gndean/bmx-start-gate/images/002-DSC09042.JPG

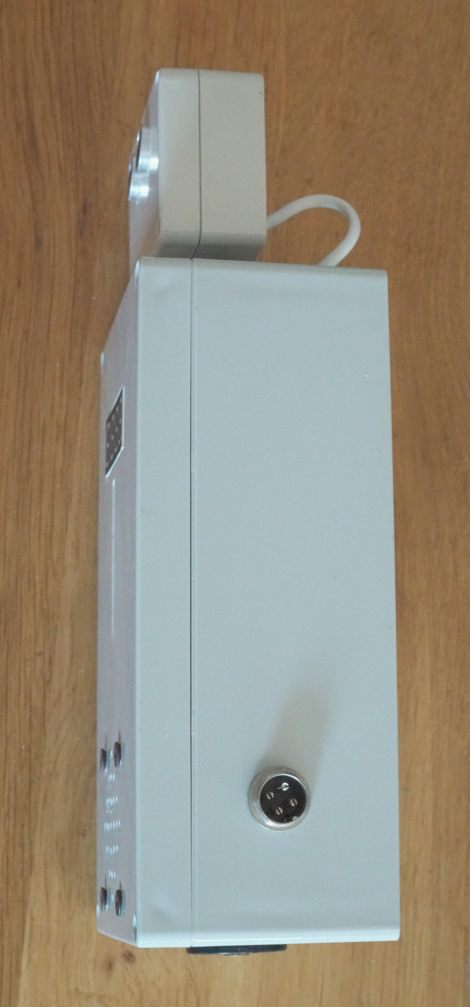
images/002-DSC09042.JPG
