gndean/bmx-start-gate/images/003-DSC09043.JPG

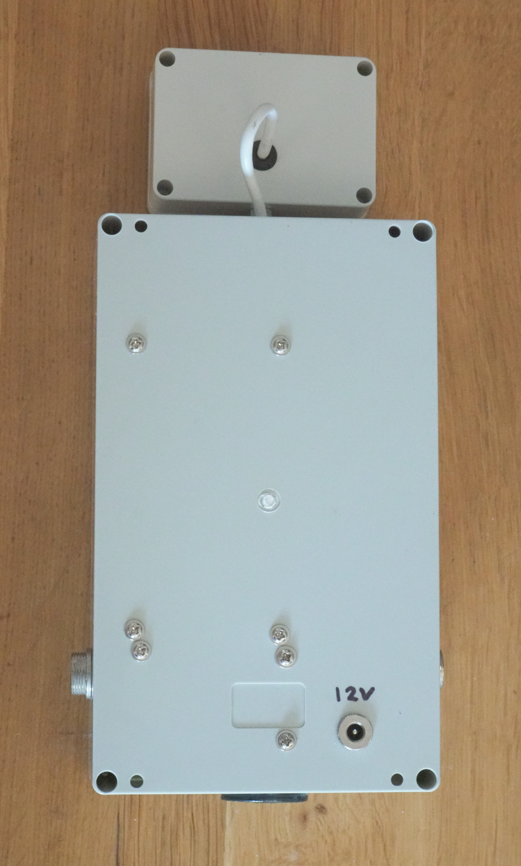
images/003-DSC09043.JPG
