gndean/bmx-start-gate/images/004-DSC09046.JPG

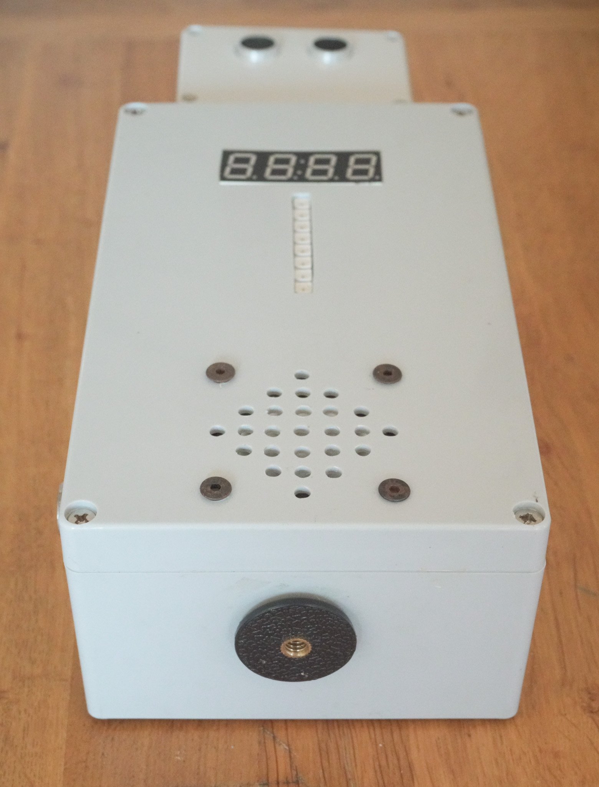
images/004-DSC09046.JPG
