gndean/bmx-start-gate/images/005-DSC09047.JPG

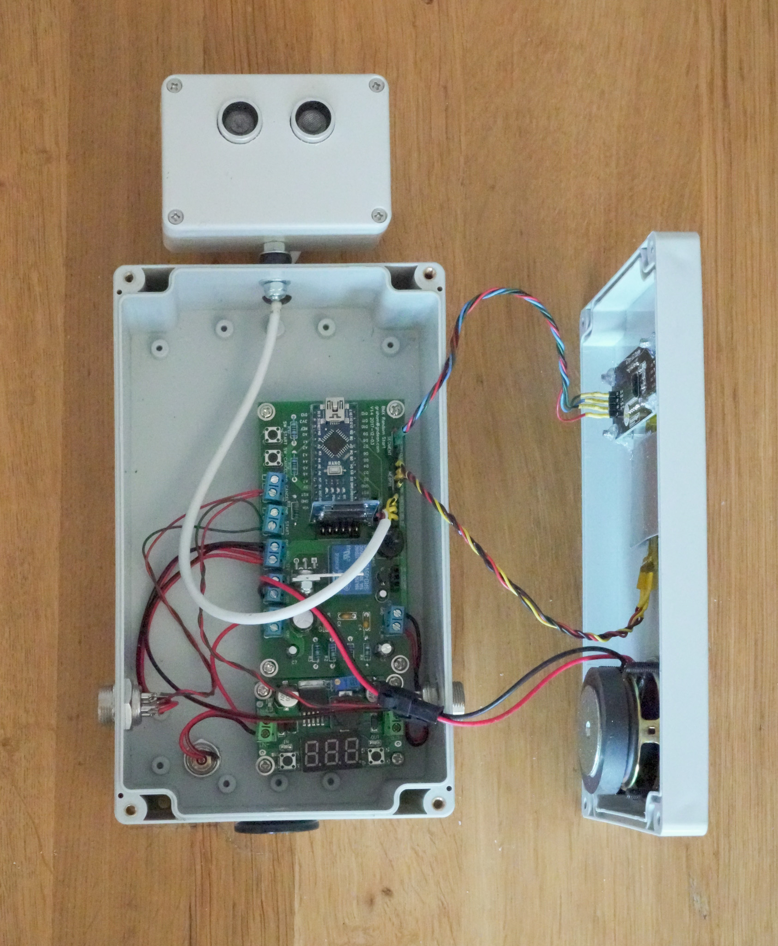
images/005-DSC09047.JPG
