gndean/bmx-start-gate/images/007-DSC09054.JPG

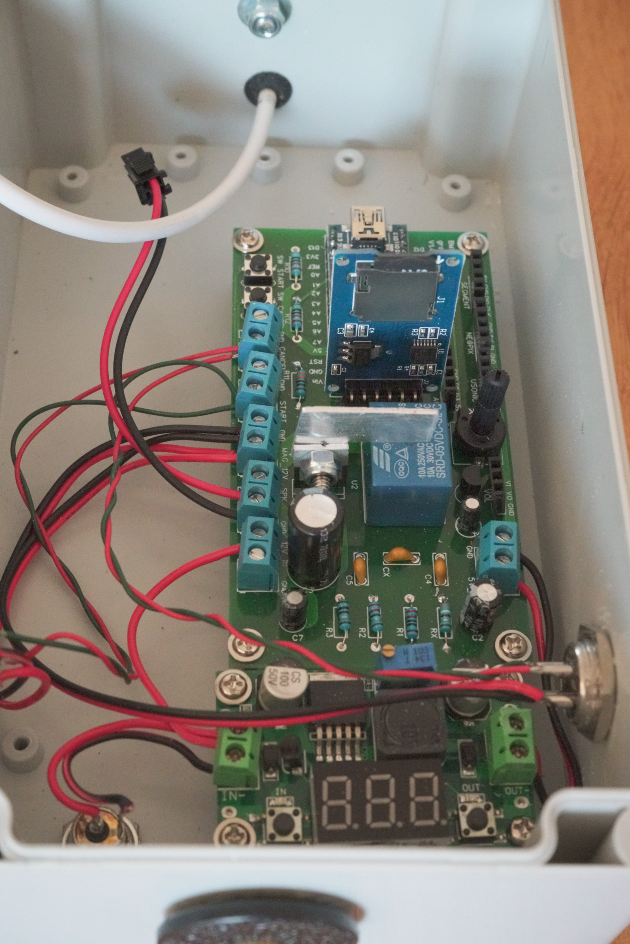
images/007-DSC09054.JPG
