gndean/bmx-start-gate/images/008-DSC09060.JPG

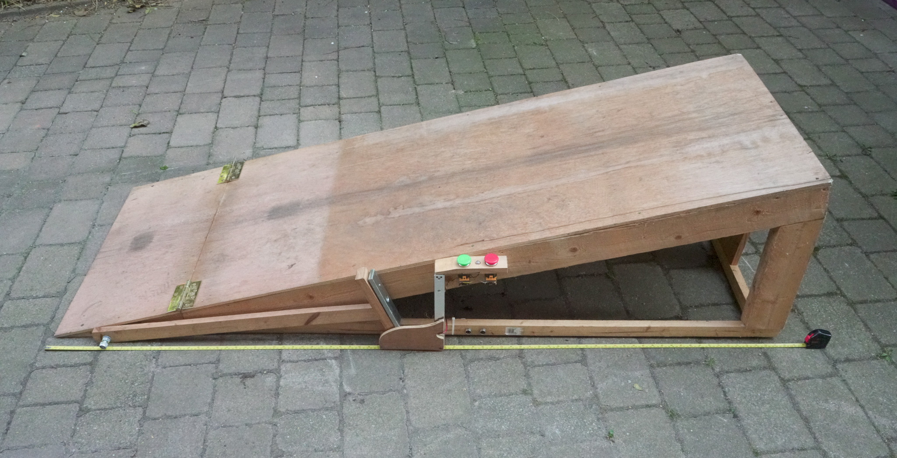
images/008-DSC09060.JPG
