gndean/bmx-start-gate/images/009-DSC09062.JPG

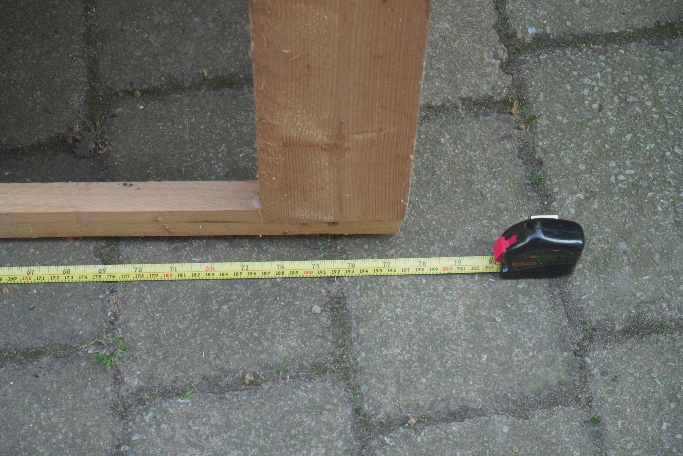
images/009-DSC09062.JPG
