gndean/bmx-start-gate/images/010-DSC09063.JPG

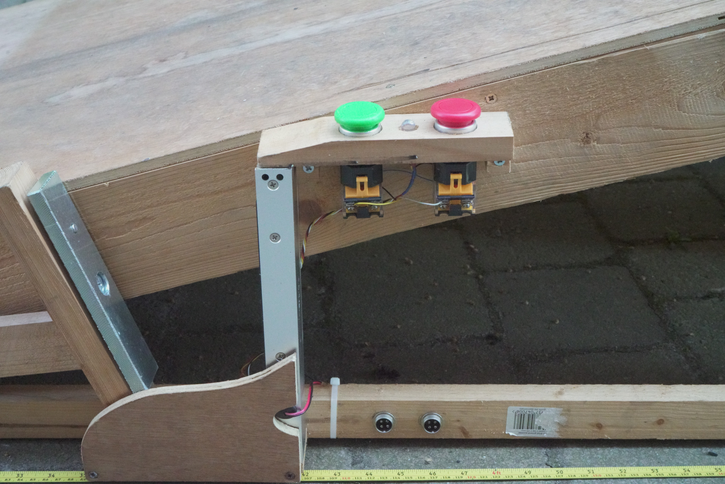
images/010-DSC09063.JPG
