gndean/bmx-start-gate/images/011-DSC09066.JPG

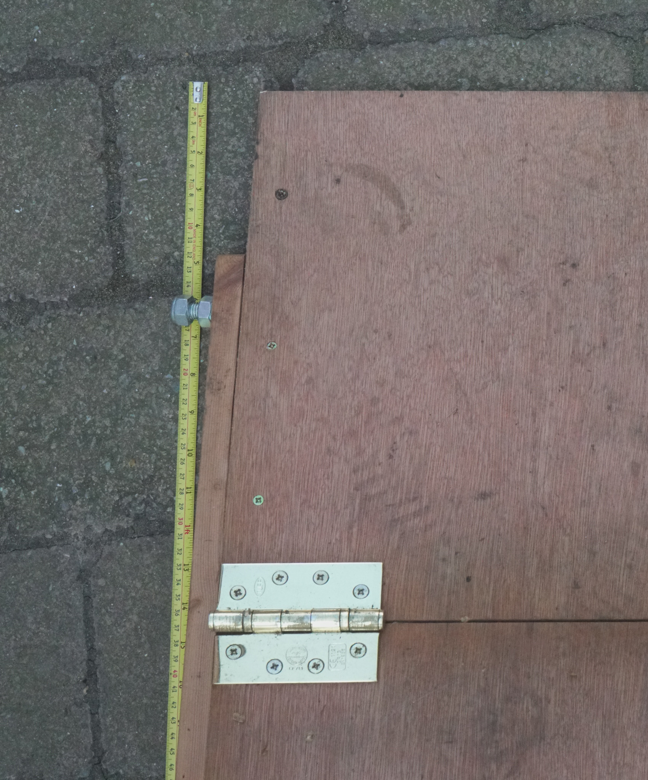
images/011-DSC09066.JPG
