gndean/bmx-start-gate/images/012-DSC09067.JPG

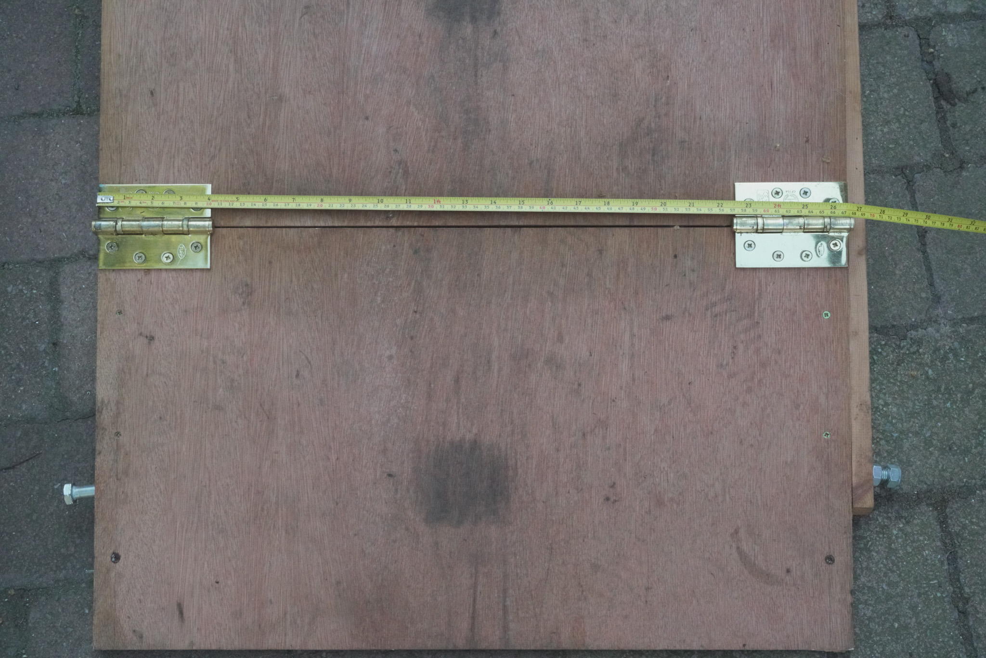
images/012-DSC09067.JPG
