gndean/bmx-start-gate/images/013-DSC09070.JPG

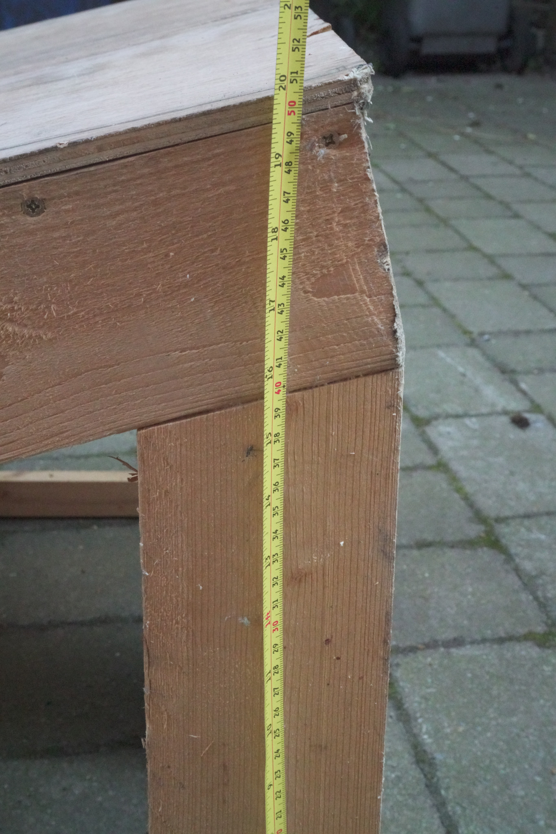
images/013-DSC09070.JPG
