gndean/bmx-start-gate/images/014-DSC09071.JPG

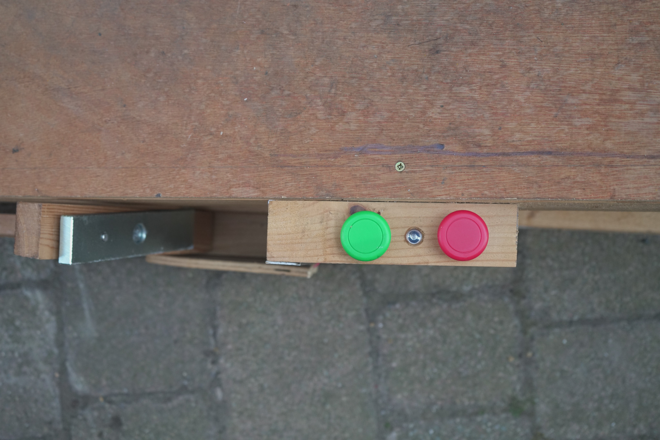
images/014-DSC09071.JPG
