gndean/bmx-start-gate/images/015-DSC09072.JPG

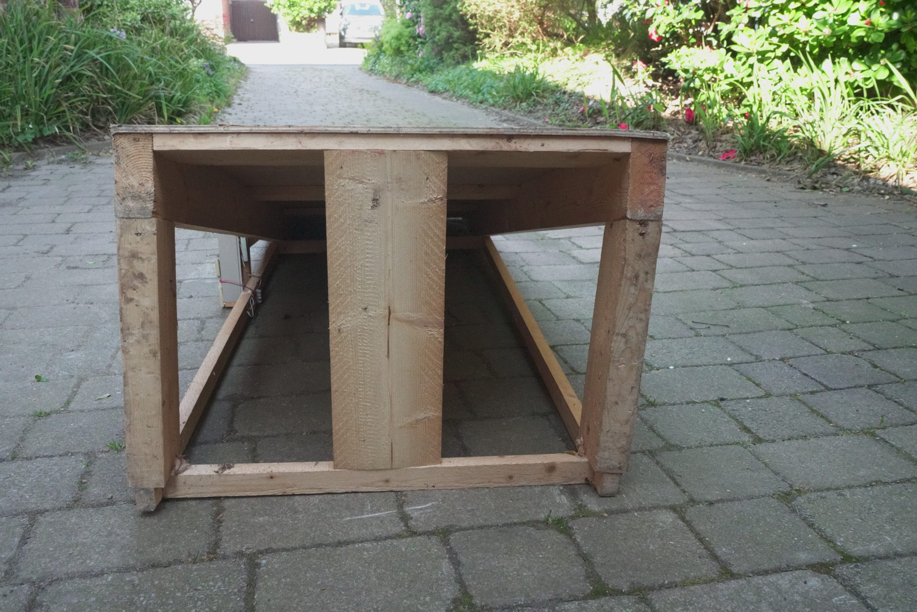
images/015-DSC09072.JPG
