gndean/bmx-start-gate/images/016-DSC09074.JPG

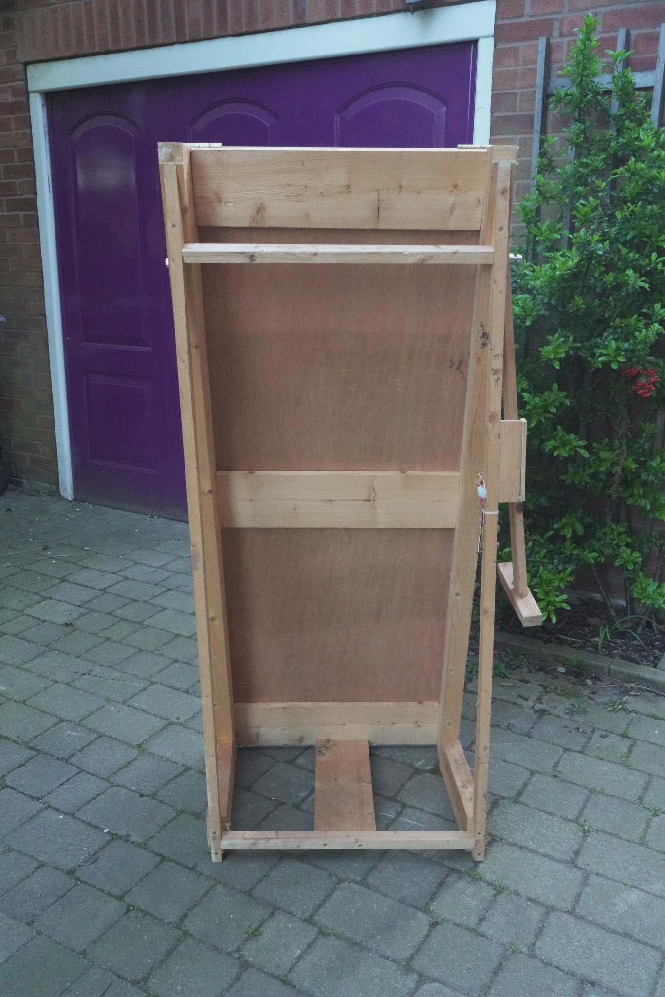
images/016-DSC09074.JPG
