gndean/bmx-start-gate/images/017-DSC09075.JPG

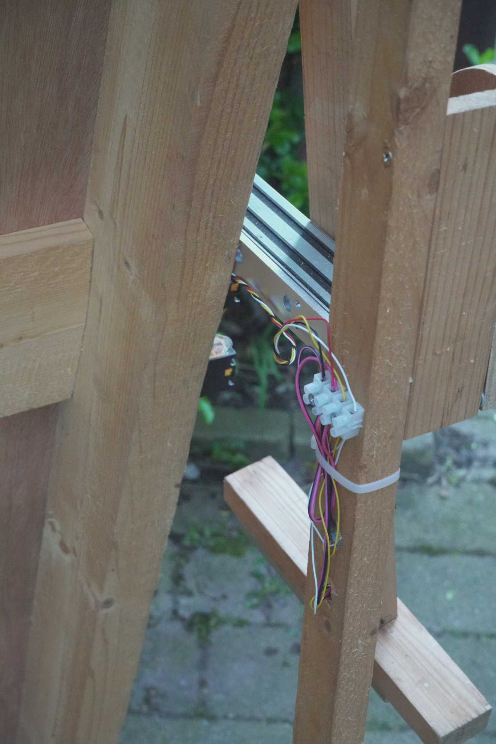
images/017-DSC09075.JPG
