gndean/bmx-start-gate/schematic/schematic_bmx_random_start.pdf

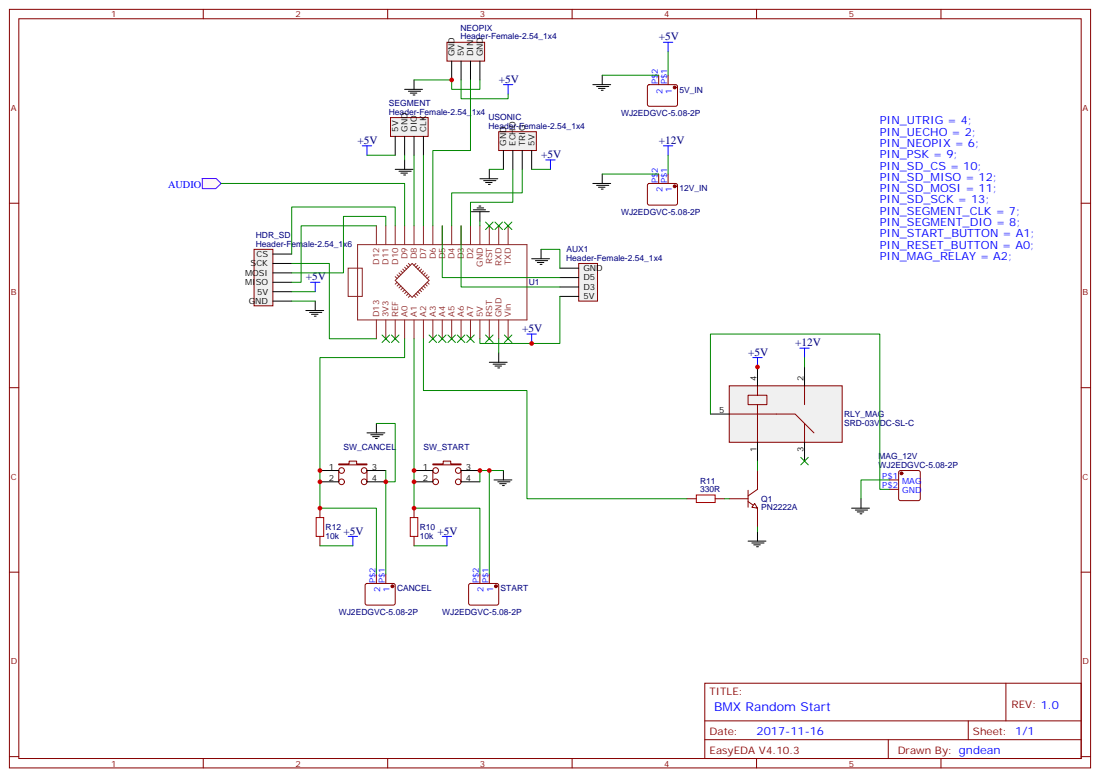
[picture p19: page 1]

USONIC GND ECHO TRIG
Header-Female-2.54_1x4

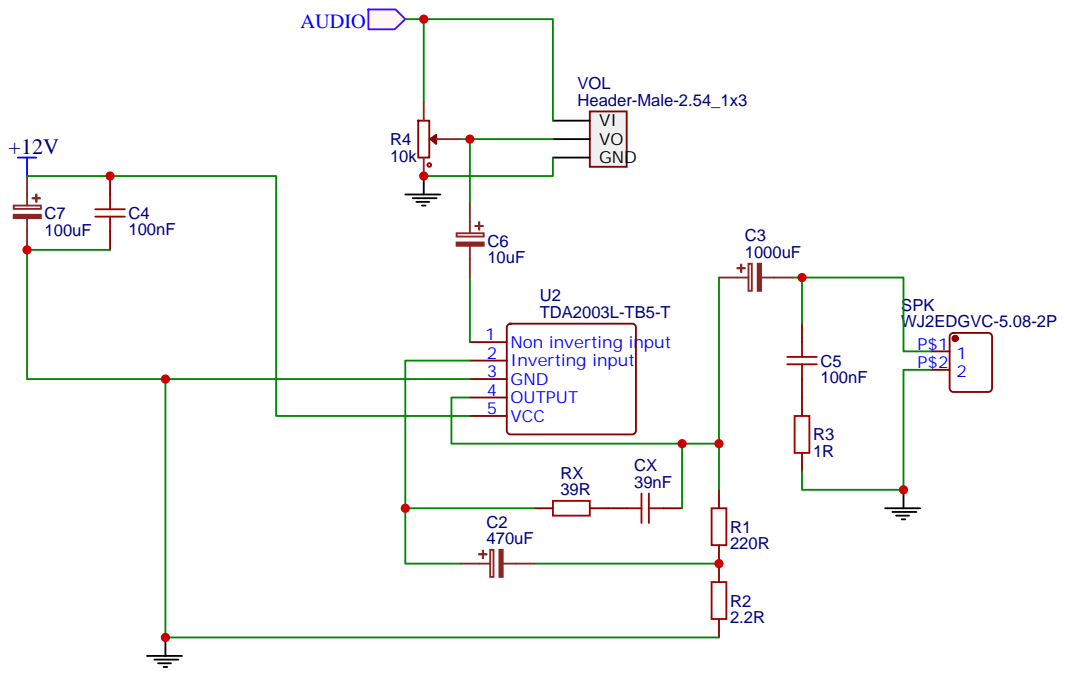
[picture p20: page 2]
