gndean/bmx-start-gate/control_box/control_box.pdf

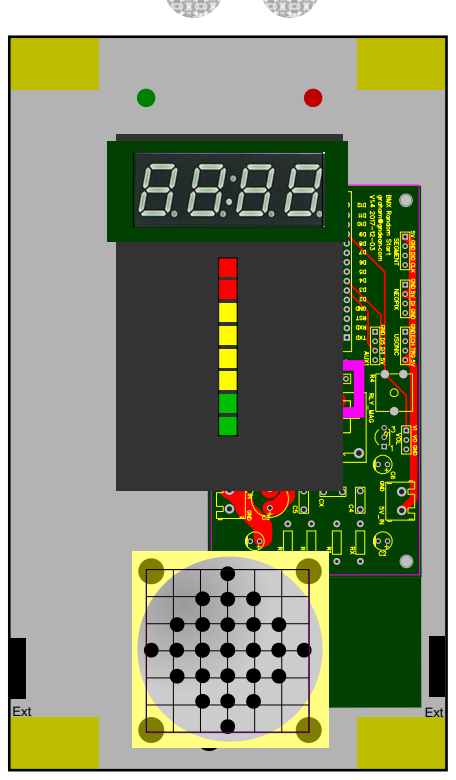
[picture p21: page 1]
Power; Ext
