gndean/bmx-start-gate/pcb/pcb_bmx_random_start_layers_merged_colour.pdf

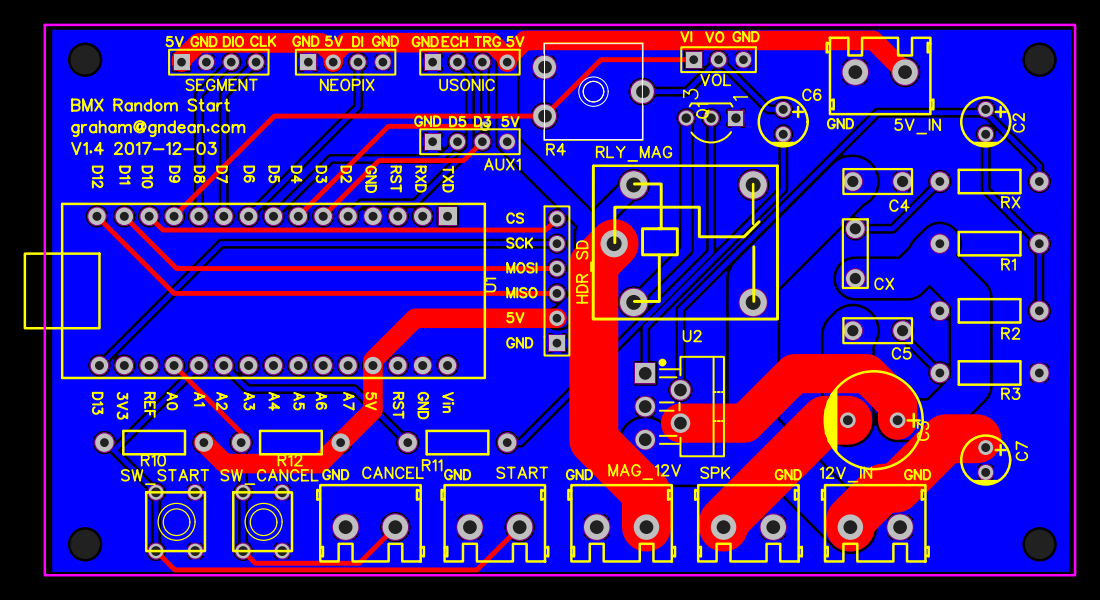
[picture p22: page 1]
