gndean/bmx-start-gate/pcb/pcb_bmx_random_start_layers_merged_monochrome.pdf

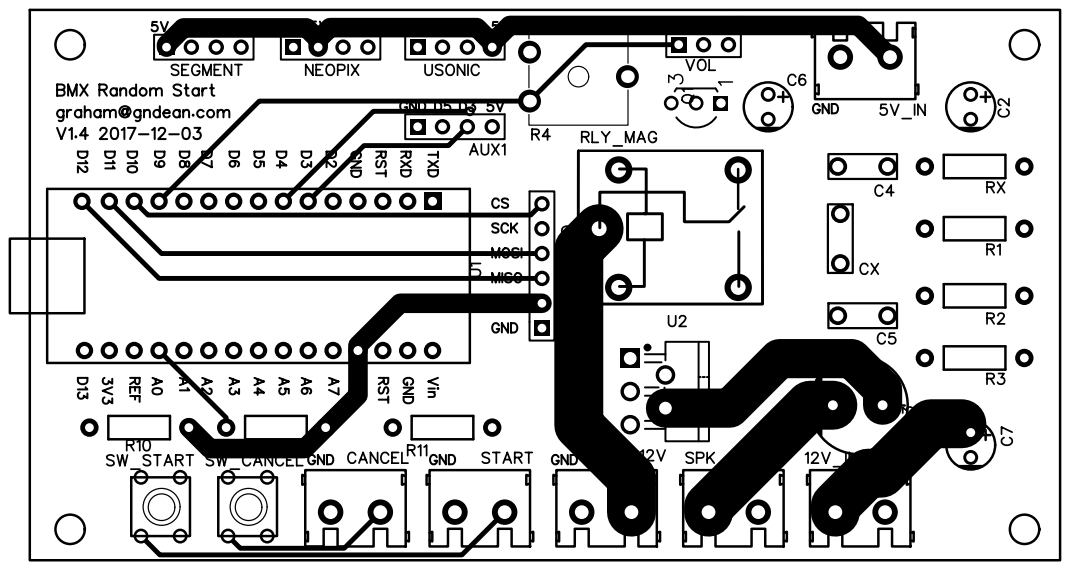
[picture p23: page 1]
