gndean/bmx-start-gate/(threads)

Thread 1 (2024-02-29):

PCB Way Share & Sell

dan99git, 2024-02-29:
Are you able to set this project up as a turn key printed and assembled item on PCB Way using 'Share & Sell'? Ive got no idea how to order these things, so it would be super helpful becasue I would like to have a go at this project. As I understand it, you also get a commision.
