gndean/bmx-start-gate/arduino/gate_seq/sd_utils.ino

void sd_print_root() {
  File root = SD.open("/");
  sd_print_directory(root, 0);
}

void sd_print_directory(File dir, int numTabs) {
  
  while (true) {

    File entry =  dir.openNextFile();
    if (! entry) {
      // no more files
      break;
    }
    for (uint8_t i = 0; i < numTabs; i++) {
      Serial.print('\t');
    }
    Serial.print(entry.name());
    if (entry.isDirectory()) {
      Serial.println("/");
      sd_print_directory(entry, numTabs + 1);
    } else {
      // files have sizes, directories do not
      Serial.print("\t\t");
      Serial.println(entry.size(), DEC);
    }
    entry.close();
  }
}
