gndean/bmx-start-gate/(commit log)

2017-11-08 Adding files. gate_seq is the latest which: - Plays voice audio - Outputs light sequence (to 4 separate outputs) - Calibrates usonic distance - Waits till usonic distance is 2/3rds
2017-11-09 Tweaks before trying Neopixel and display tube
2017-11-15 Added support for start button
2017-11-16 Had some reliability issues with the pixel stick when lighting up to 255 brightness. Reduced to 100 and it seems fine now. Added test_loop_mode to run sequence in endless loop to test reliability
    [gate_seq.ino]
2017-11-21 - Added test loop mode - Added support for reset button
2017-11-30 Corrected SD pin numbers. Reversed the polarity of the start and cancel buttons - they are now push to low.
    [gate_seq.ino]
2020-04-13 Rename of arduino directory and addition of other directories
2020-04-13 Added README. Moved arduino source
